jordonsc/dosa/docs/SecBot.md

DOSA Security Bot
=================
The SecBot is designed to be a voice-based security alert system. It can run off any Python-capable platform and is
ideal for a Raspberry Pi device. It can also act as the central logging and stats agent.

Installing Datadog on a Pi
--------------------------
A custom-built DD agent for Raspberry Pi 4 Model B is available
[here](https://github.com/adrienkohlbecker/datadog-agent-arm/releases/download/6.15.0/datadog-agent_6.15.0.ak-1_armhf.deb).
