jordonsc/dosa/(commit log)

2021-08-18 Reworked to be more IDE-friendly, base BT work for both devices
    [main.cc]
2021-08-26 Resolved stability issues; refactored sensor class
    [main.cc]
2021-08-28 Preparing larger roadmap, main driver now known as 'door' controller
2021-08-29 Added onboard LED controls; start door sequencing
2021-09-01 Added reed switch; reduce switch debounce threshold; attempted current-based kill switch, did not work - current value too random
2021-09-04 Added stall protection via interrupts on CPR pulses
2021-09-05 Worked around Arduino -D issue; updated timings; added PIR sensor into door trigger functions
2021-09-11 Door will now hold open if sensors are active; tick-based high-speed threshold
2021-09-12 After several field tests, using a tick-based kill mechanism is working best (with current hardware robustness); added define option to toggle this behavior
2021-10-24 Fixed stupid build.extra_flags issue; ground work for wifi
2021-10-25 Updates for sensor sensitivity and door interrupts
2021-10-25 Switching from BT subscribe to a polling system with auto-disconnect on read error
    [read_serial.py]
2022-01-17 Experimental build of GridEYE sensor logic
2022-01-18 Moved door light LED pin to accommodate FRAM on door device
2022-01-20 Sensor app now integrated with new settings & message framework
2022-01-21 Wifi connection resilience; added Python script to switch from wifi to BT mode
2022-01-27 Tweaked calibration to allow for a thin shield over the IR grid; added Python script to listen for triggers and ack them
2022-01-29 Fixed indexing in ack script, added device name to output
2022-01-29 Added more robust messaging; removed ack script in favour of more powerful snoop script
2022-02-03 Added door calibration via network
2022-02-12 Added 'sonar' app and new serial interface for it
2022-02-12 Switching sonar serial to use the built-in RX/TX pins on Serial1
2022-02-13 Reconfigured the door for sonar open threshold
2022-02-13 Added de-noising thresholds to sonar app
2022-02-17 Adding monitor application; reworked docs
    [monitor.ino]
2022-02-17 Groundwork for Inkplate code
2022-02-17 Added icons and basic layout prototype
2022-02-19 Split Inkplate app into modules similar to normal Arduino apps
2022-02-20 Cleaned up Arduino board dependencies
2022-02-25 Fixed segfault issue; improved wifi logic
    [monitor.ino]
2022-02-27 Minor refactoring of sonar; monitor now displays list of devices; switched Vector library for Array library
2022-03-05 Monitor now audits device state
2022-03-06 Fixed screen refresh on btn 2; reduced time to declare device unresponsive
2022-03-10 Adding LED support
2022-03-12 groundwork for OTA updates
2022-03-13 OTA updates working for Arduino boards
2022-03-14 Update for sonar state logic
2022-03-20 Added ability to upgrade settings without clean wipe; added sonar fixed calibration
2022-03-21 Added device locks
2022-03-22 Added docs for device construction
2022-03-22 Adding listen device to settings
2022-03-22 Listen device setting now code complete
2022-03-23 Added construction docs for relay
2022-03-23 Door now honors listen devices
2022-03-23 Fixed IrGrid Wire dependency; fixed Sensor app trigger type
2022-03-23 Added relay device
2022-03-24 Relay now sends state in the same way the door does
2022-03-24 Relay will no longer send repeat 'BEGIN' messages when it receives superfluous triggers
2022-03-27 Renamed sensor to pir; fix bug in monitor debug; fix bug in relay timing
2022-03-28 Experimental laser app
2022-03-28 Laser application working; sonar and laser now use the same base code
2022-04-07 Cleanup work for laser sensor
2022-04-08 Fixed mem overrun bug in Laser; SecBot now acks log messages; NetLog now requires ack
2022-04-11 Fixed all-devices option for dosa-net -c
2022-04-13 Broke Python Comms class out into it's own file; refactorings of SecBot; SecBot now alerts on device failure/unresponsiveness
2022-04-25 Door now acks while in action; sensors log metrics when triggering while locked
2022-04-26 Switched Alarm ALERT LED
2022-05-04 Laser will no longer trigger on ERR reads
2022-07-08 Increase device offline timeout to 5 mins
2022-07-13 Disabling fixed device hostname for wifi
2022-08-06 Added error handling for sonar failures, will no longer jam system; network flush will reset device state
2022-08-06 Further improvements to sonar fault handling
2022-08-12 Added fixed non-sonar mode; optimised fallback calibration
2022-08-25 Added code for recovery switch on door app
2022-08-29 Tweaked calibration rollback threshold
2022-09-02 Added new device types
2022-09-03 Updated power variables
2022-09-03 Split the DOSA SmartThings driver and Renogy bridge
2022-09-06 ST driver component names
2022-11-17 Reduced sensitivity on calibration
2023-04-20 Added PWM app, fixed bugs in build helper Added error handling for serial
    [dosa-renogy.py, pwm.cc, read_serial.py]
2023-04-20 Added mega AVR arch; fixed hardware PWM
2023-04-20 Added mains LEDs to renogy app
2023-04-20 Foundation work for a power grid GUI
2023-04-20 Fixes for SmartThings drivers Refactoring the 'Renogy' out of the power grid, controller writing to file Added in a GUI application using Kivy
    [dosa-grid-ui.py, dosa-grid.py]
2023-04-20 Fully removed Renogy from DOSA Power Grid device names Removed 'Renogy' from power grid class names; changed power calculations
2023-04-26 Added mains config buttons to GUI Moved settings to its own widget
2023-04-27 Changing logic for load LEDs
2023-05-02 Decrease warn threshold; added mains pin
2023-05-02 Changed LED order; updated exception on BLE disconnect
2023-05-10 Tweaking upper thresholds for battery maintenance
2023-07-12 Tweaking power storage settings
2023-09-11 tweak winter power settings
2023-09-15 Added additional power sensitivity option
2023-09-18 power tweaks
2024-04-17 Added exit condition for shunt failure
    [dosa-grid.py]
